rcjcooke/ha-soap-press/3DPrint/Walls.stl

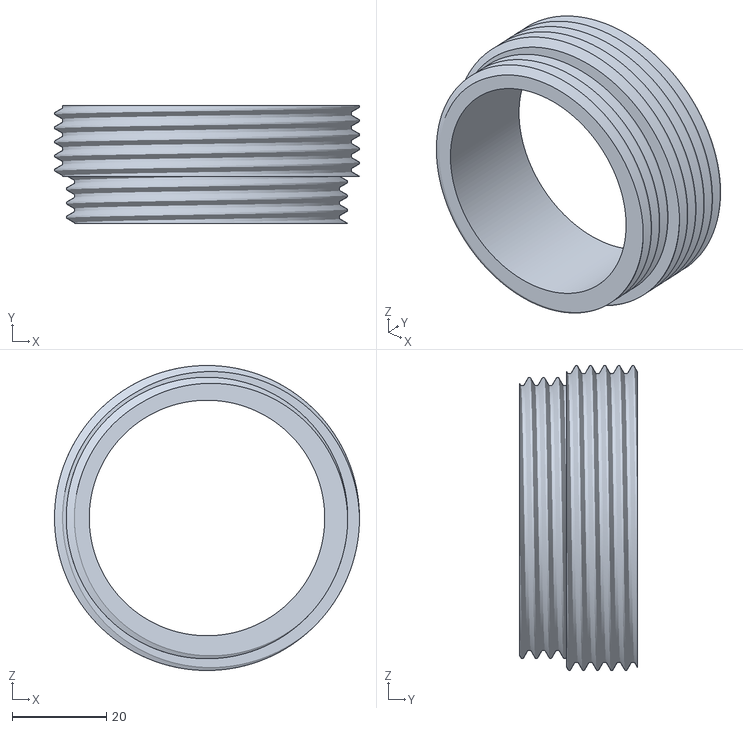
[picture p8: CAD file, 2019-04-01]
3DPrint/Walls.stl
64.8 x 25.0 x 64.8
