rcjcooke/ha-soap-press/3DPrint/Base.stl

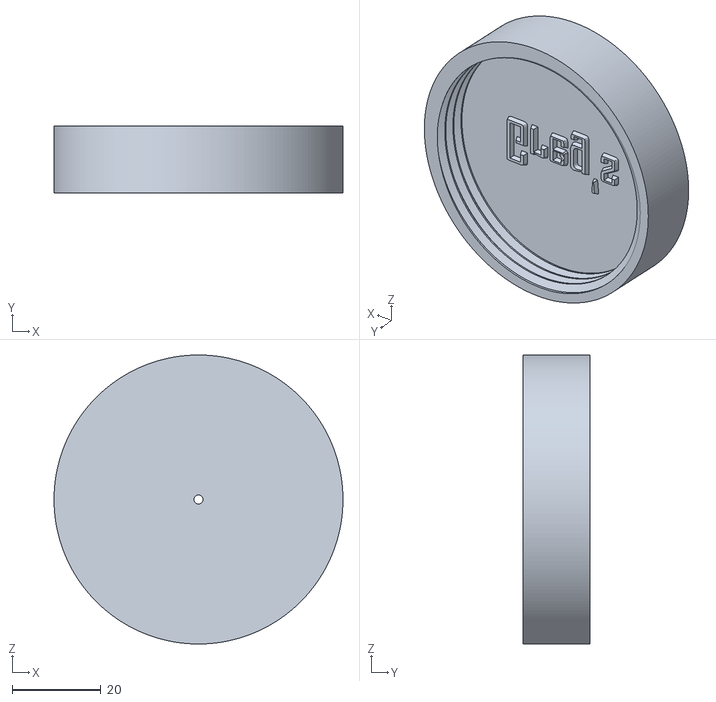
[picture p9: CAD file, 2019-04-01]
3DPrint/Base.stl
65.0 x 15.0 x 65.0
