rcjcooke/ha-soap-press/3DPrint/Press.stl

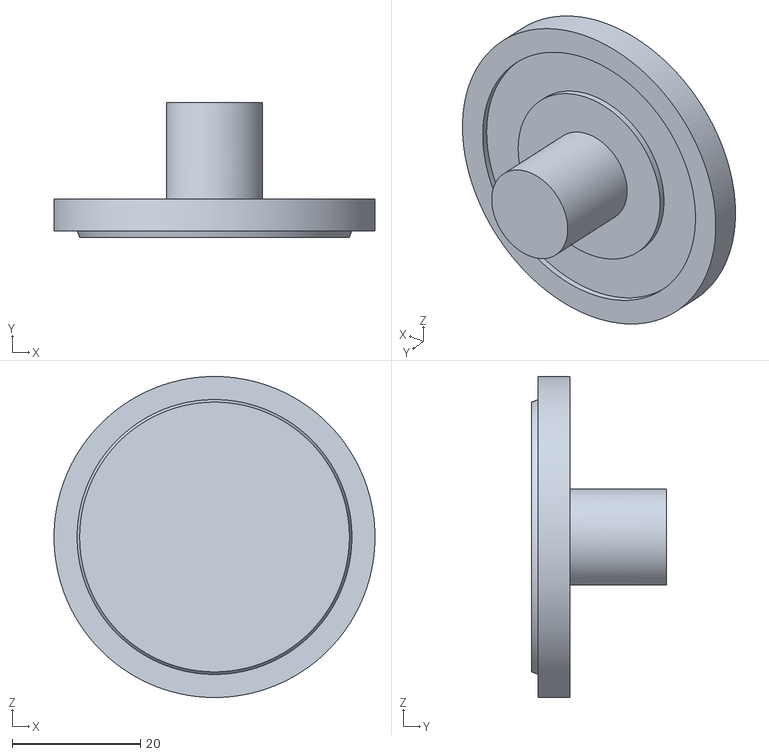
[picture p10: CAD file, 2019-04-01]
3DPrint/Press.stl
50.0 x 21.0 x 50.0
