rcjcooke/ha-soap-press/3DPrint/Top.stl

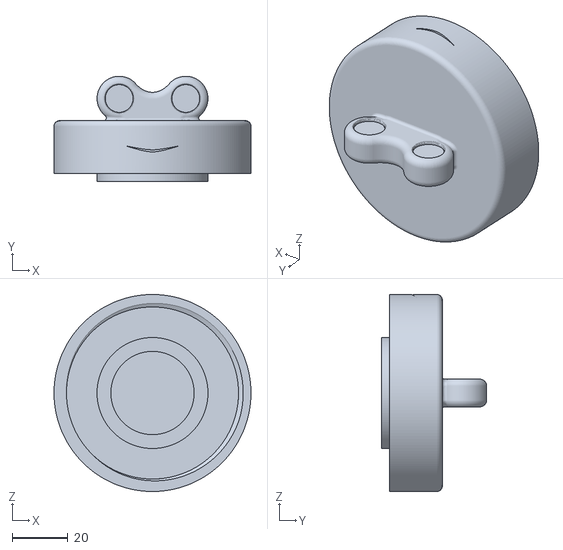
[picture p11: CAD file, 2019-04-01]
3DPrint/Top.stl
71.0 x 38.0 x 71.0
